savob/esc/hardware/schematics/esc_driver.pdf

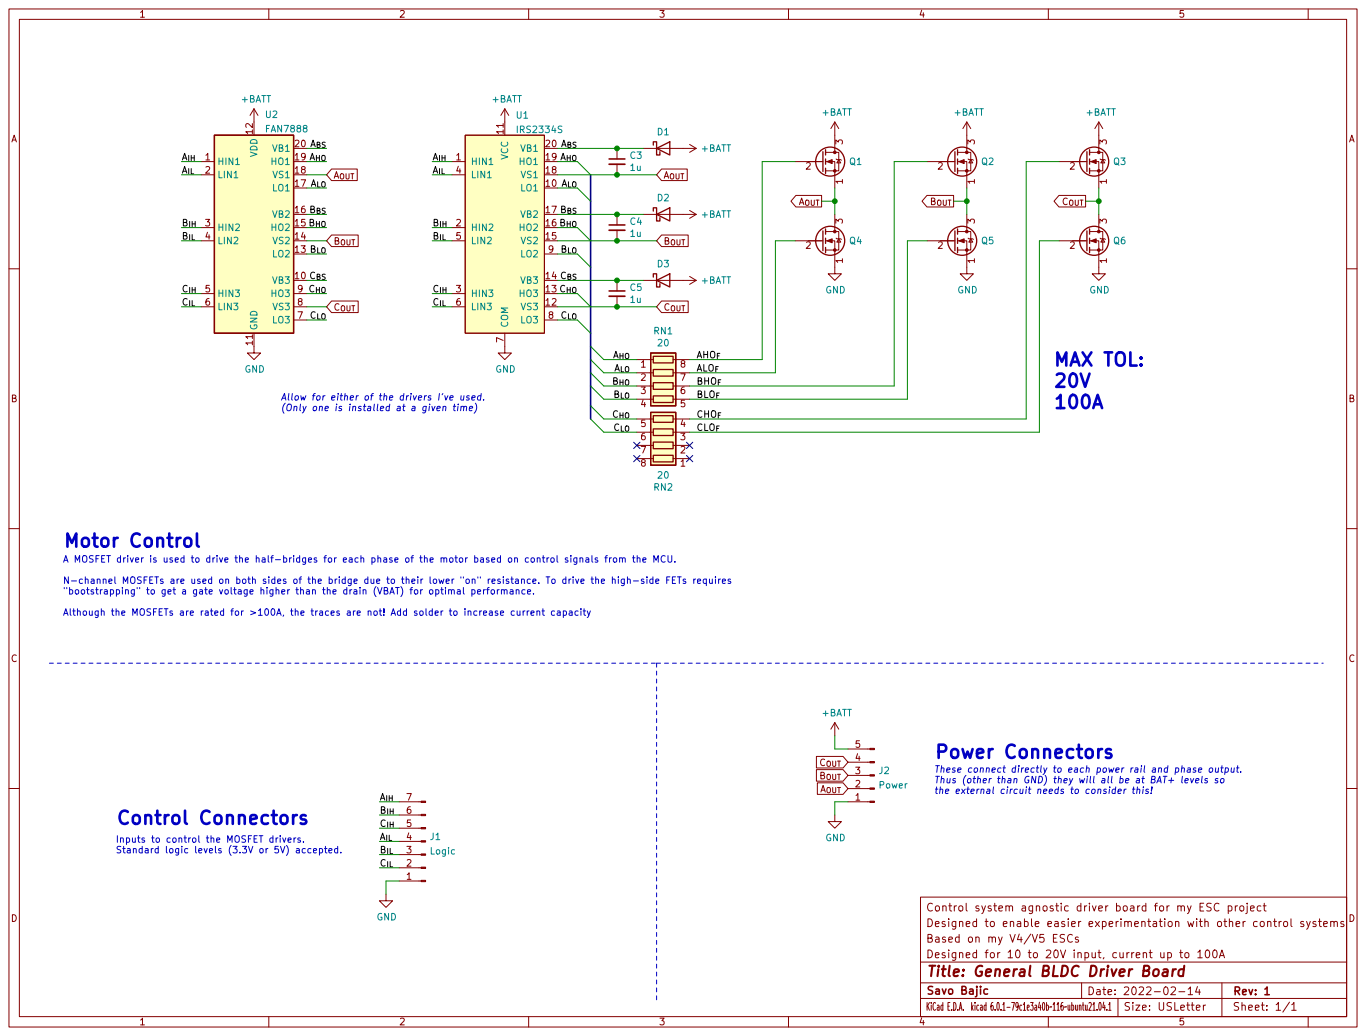
[picture p1: page 1]

Although the MOSFETs are rated for >100A, the traces are not! Add solder to increase current capacity Allow for either of the drivers I've used. (Only one is installed at a given time)

A MOSFET driver is used to drive the half-bridges for each phase of the motor based on control signals from the MCU.

N-channel MOSFETs are used on both sides of the bridge due to their lower "on" resistance. To drive the high-side FETs requires
"bootstrapping" to get a gate voltage higher than the drain (VBAT) for optimal performance.

the external circuit needs to consider this! Power Connectors

These connect directly to each power rail and phase output.
Thus (other than GND) they will all be at BAT+ levels so

Inputs to control the MOSFET drivers.
Standard logic levels (3.3V or 5V) accepted.

Control system agnostic driver board for my ESC project KiCad E.D.A. kicad 6.0.1-79c1e3a40b~116~ubuntu21.04.1
Designed to enable easier experimentation with other control systems
Based on my V4/V5 ESCs
Designed for 10 to 20V input, current up to 100A
