savob/esc/hardware/schematics/esc_V1.pdf

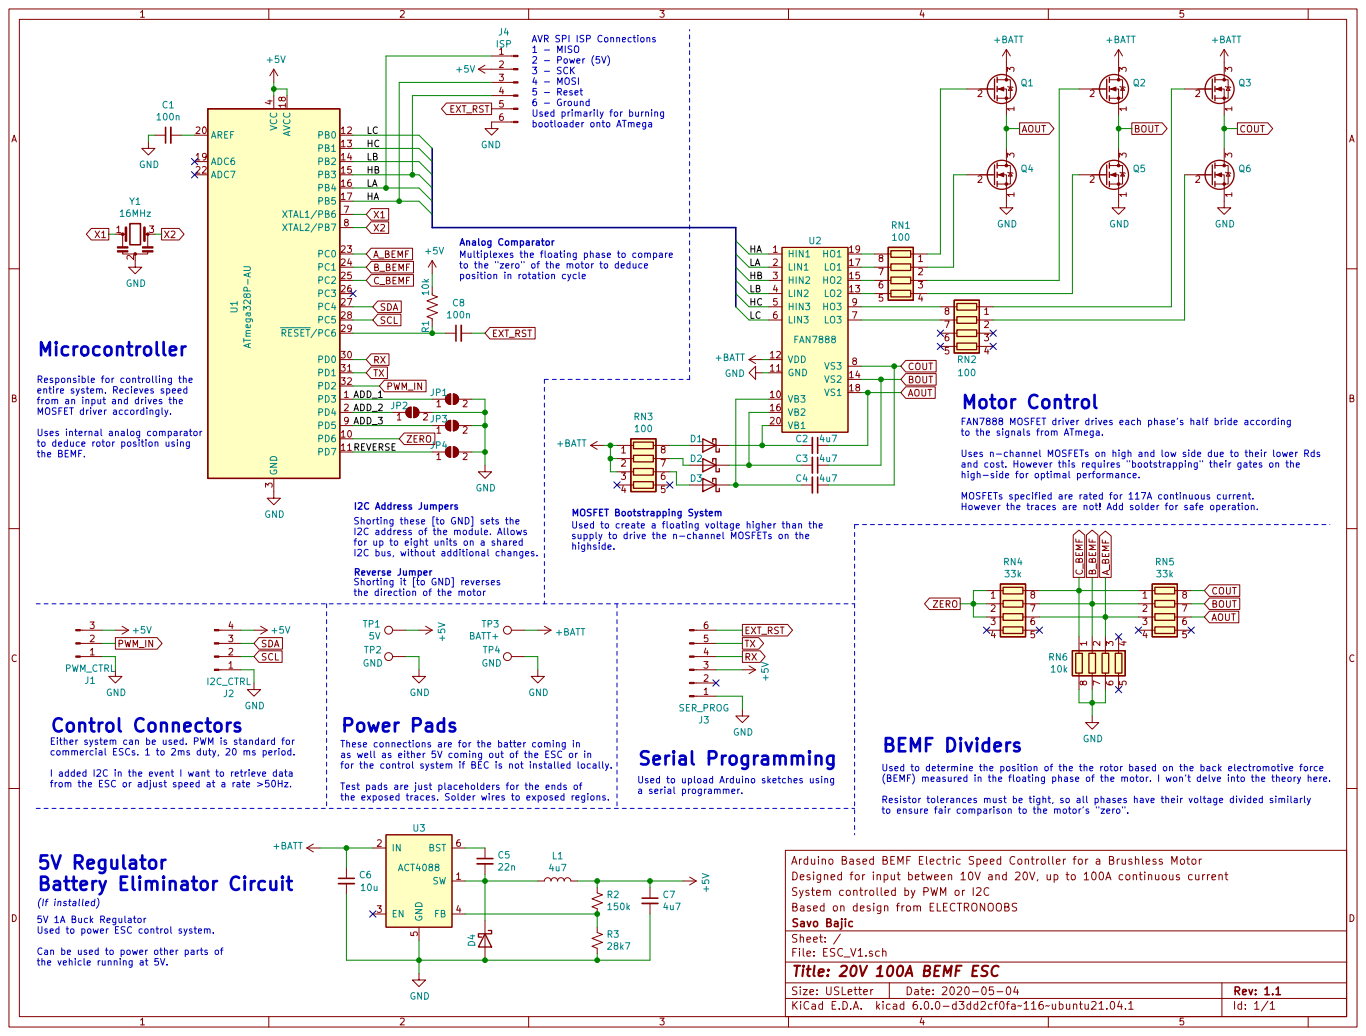
[picture p3: page 1]

HC
LB

Analog Comparator
Multiplexes the floating phase to compare
to the "zero" of the motor to deduce
position in rotation cycle

Responsible for controlling the
entire system. Recieves speed
from an input and drives the
MOSFET driver accordingly.

Uses internal analog comparator
to deduce rotor position using

to the signals from ATmega.

Uses n-channel MOSFETs on high and low side due to their lower Rds
and cost. However this requires "bootstrapping" their gates on the
high-side for optimal performance.

MOSFETs specified are rated for 117A continuous current.
However the traces are not! Add solder for safe operation.

I2C Address Jumpers
Shorting these [to GND] sets the
I2C address of the module. Allows
for up to eight units on a shared
I2C bus, without additional changes.

MOSFET Bootstrapping System
Used to create a floating voltage higher than the
supply to drive the n-channel MOSFETs on the
highside.

Shorting it [to GND] reverses

4u7 TP3 BATT+ TP4 GND GND +5V GND

Either system can be used. PWM is standard for
commercial ESCs. 1 to 2ms duty, 20 ms period.

These connections are for the batter coming in
as well as either 5V coming out of the ESC or in
for the control system if BEC is not installed locally.

I added I2C in the event I want to retrieve data
from the ESC or adjust speed at a rate >50Hz.

Used to determine the position of the the rotor based on the back electromotive force
(BEMF) measured in the floating phase of the motor. I won't delve into the theory here.

Test pads are just placeholders for the ends of
the exposed traces. Solder wires to exposed regions.

Used to upload Arduino sketches using
a serial programmer.

Resistor tolerances must be tight, so all phases have their voltage divided similarly
to ensure fair comparison to the motor's "zero".

Arduino Based BEMF Electric Speed Controller for a Brushless Motor R2

Designed for input between 10V and 20V, up to 100A continuous current
System controlled by PWM or I2C
Based on design from ELECTRONOOBS
File: ESC_V1.sch Sheet: / Savo Bajic

(If installed)
5V 1A Buck Regulator
Used to power ESC control system.

Can be used to power other parts of
the vehicle running at 5V.

Id: 1/1 Title: 20V 100A BEMF ESC
