savob/esc/hardware/esc_driver/esc_driver.kicad_pcb

## KiCad design hardware/esc_driver/esc_driver.kicad_pcb (2024-01-04)

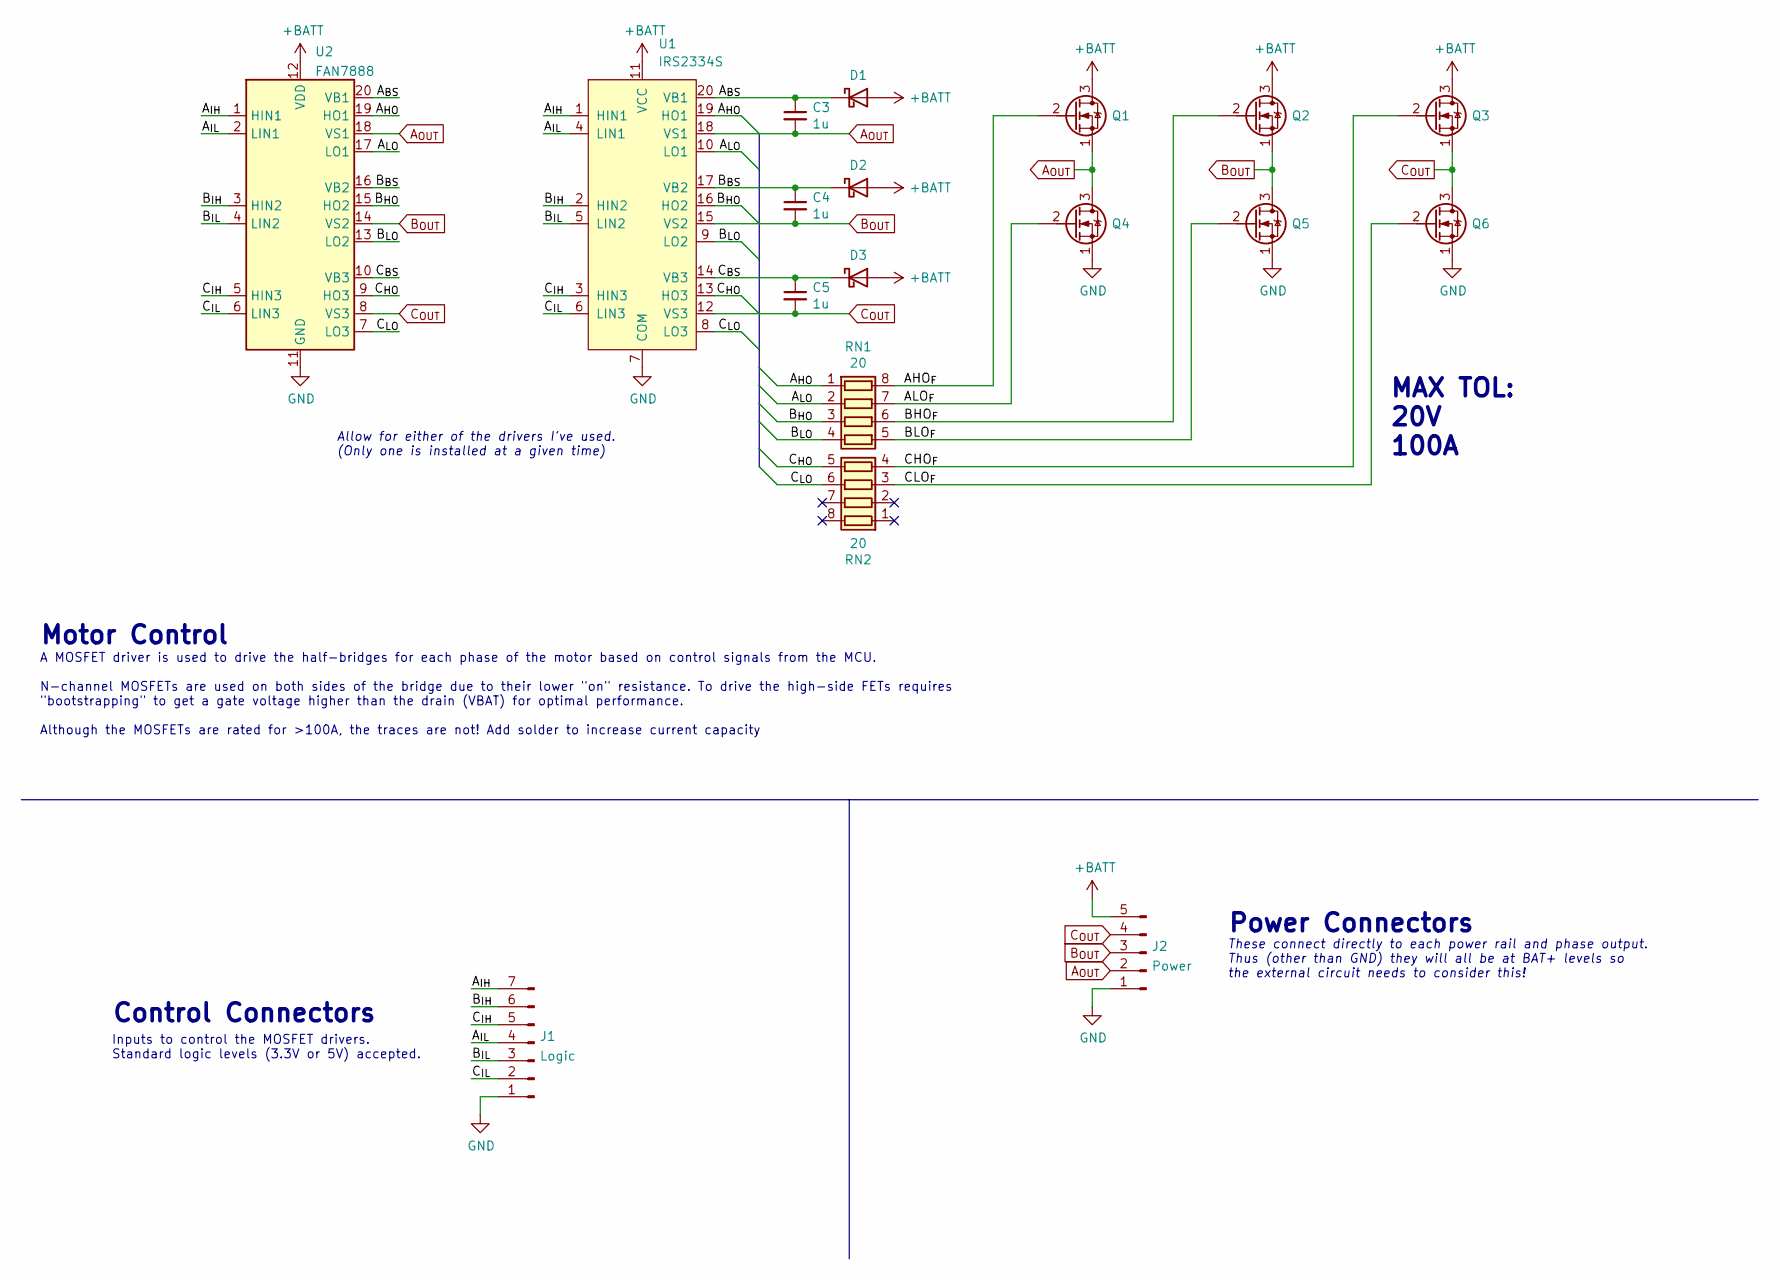
[picture p4: schematic esc_driver.kicad_sch, General BLDC Driver Board]

Parts:
C3, C4, C5: 1u; C_0603_1608Metric
D1, D2, D3: DSS15UTR; D_SOD-123F
J1: Logic; PinHeader_1x07_P2.54mm_Vertical
J2: Power; PinHeader_1x05_P2.54mm_Vertical
Q1, Q2, Q3, Q4, Q5, Q6: TPN2R903PL; TPN2R903PLL1Q
RN1, RN2: 20; R_Array_Convex_4x0603
U1: IRS2334S; SOIC-20W_7.5x12.8mm_P1.27mm
U2: FAN7888; SOIC-20W_7.5x12.8mm_P1.27mm

Connections:
+BATT: D1.2 (A), D2.2 (A), D3.2 (A), J2.5, Q1.3 (D), Q2.3 (D), Q3.3 (D), U1.11 (VCC), U2.12 (VDD)
/AHO_{F}: Q1.2 (G), RN1.8 (R1.2)
/ALO_{F}: Q4.2 (G), RN1.7 (R2.2)
/A_{BS}: C3.1, D1.1 (K), U1.20 (VB1), U2.20 (VB1)
/A_{HO}: RN1.1 (R1.1), U1.19 (HO1), U2.19 (HO1)
/A_{IH}: J1.7, U1.1 (HIN1), U2.1 (HIN1)
/A_{IL}: J1.4, U1.4 (LIN1), U2.2 (LIN1)
/A_{LO}: RN1.2 (R2.1), U1.10 (LO1), U2.17 (LO1)
/BHO_{F}: Q2.2 (G), RN1.6 (R3.2)
/BLO_{F}: Q5.2 (G), RN1.5 (R4.2)
/B_{BS}: C4.1, D2.1 (K), U1.17 (VB2), U2.16 (VB2)
/B_{HO}: RN1.3 (R3.1), U1.16 (HO2), U2.15 (HO2)
/B_{IH}: J1.6, U1.2 (HIN2), U2.3 (HIN2)
/B_{IL}: J1.3, U1.5 (LIN2), U2.4 (LIN2)
/B_{LO}: RN1.4 (R4.1), U1.9 (LO2), U2.13 (LO2)
/CHO_{F}: Q3.2 (G), RN2.4 (R4.1)
/CLO_{F}: Q6.2 (G), RN2.3 (R3.1)
/C_{BS}: C5.1, D3.1 (K), U1.14 (VB3), U2.10 (VB3)
/C_{HO}: RN2.5 (R4.2), U1.13 (HO3), U2.9 (HO3)
/C_{IH}: J1.5, U1.3 (HIN3), U2.5 (HIN3)
/C_{IL}: J1.2, U1.6 (LIN3), U2.6 (LIN3)
/C_{LO}: RN2.6 (R3.2), U1.8 (LO3), U2.7 (LO3)
A_{OUT}: C3.2, J2.2, Q1.1 (S), Q4.3 (D), U1.18 (VS1), U2.18 (VS1)
B_{OUT}: C4.2, J2.3, Q2.1 (S), Q5.3 (D), U1.15 (VS2), U2.14 (VS2)
C_{OUT}: C5.2, J2.4, Q3.1 (S), Q6.3 (D), U1.12 (VS3), U2.8 (VS3)
GND: J1.1, J2.1, Q4.1 (S), Q5.1 (S), Q6.1 (S), U1.7 (COM), U2.11 (GND)

Notes on the sheet:
A MOSFET driver is used to drive the half-bridges for each phase of the motor based on control signals from the MCU. N-channel MOSFETs are used on both sides of the bridge due to their lower "on" resistance. To drive the high-side FETs requires "bootstrapping" to get a gate voltage higher than the 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
These connect directly to each power rail and phase output. Thus (other than GND) they will all be at BAT+ levels so the external circuit needs to consider this!
Motor Control
Allow for either of the drivers I've used. (Only one is installed at a given time)
Power Connectors
MAX TOL: 20V 100A
Inputs to control the MOSFET drivers. Standard logic levels (3.3V or 5V) accepted.
Control Connectors

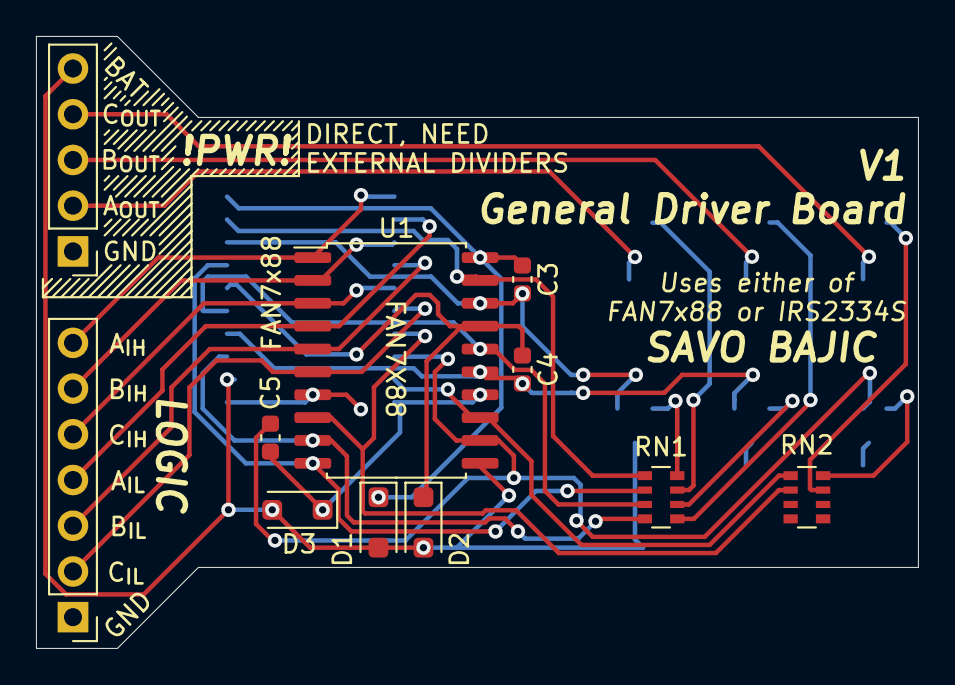
[picture p5: board esc_driver.kicad_pcb from above]

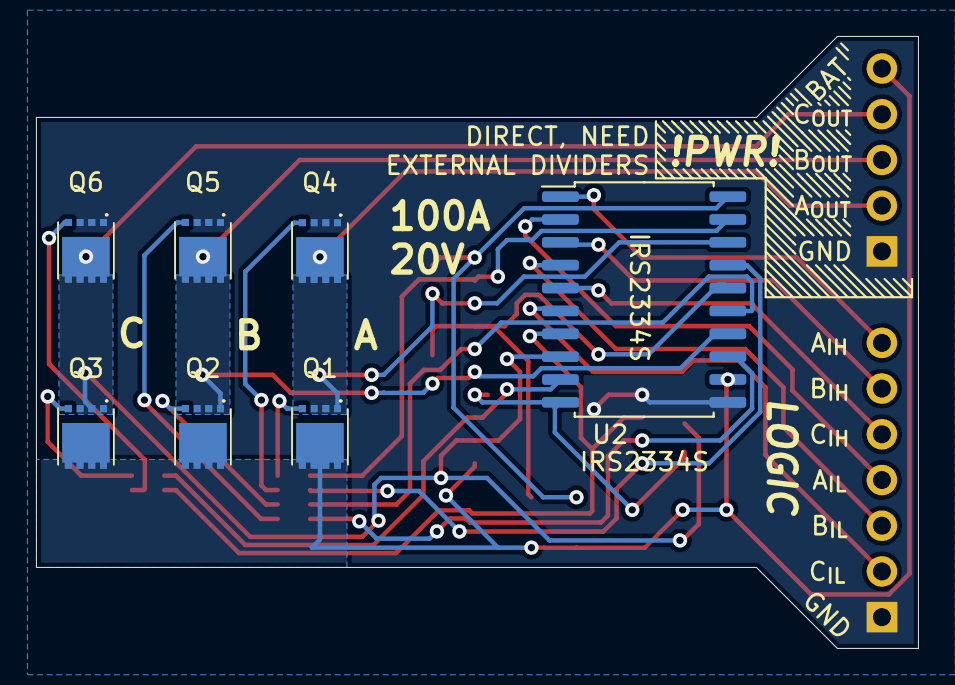
[picture p6: board esc_driver.kicad_pcb from below]

Board: 2 copper layers, 49.0 x 34.0 mm, 18 parts (7 on the bottom side), 26 nets.
