savob/esc/hardware/esc_v4/esc_v4.kicad_pcb

## KiCad design hardware/esc_v4/esc_v4.kicad_pcb (2024-01-04, an earlier design)

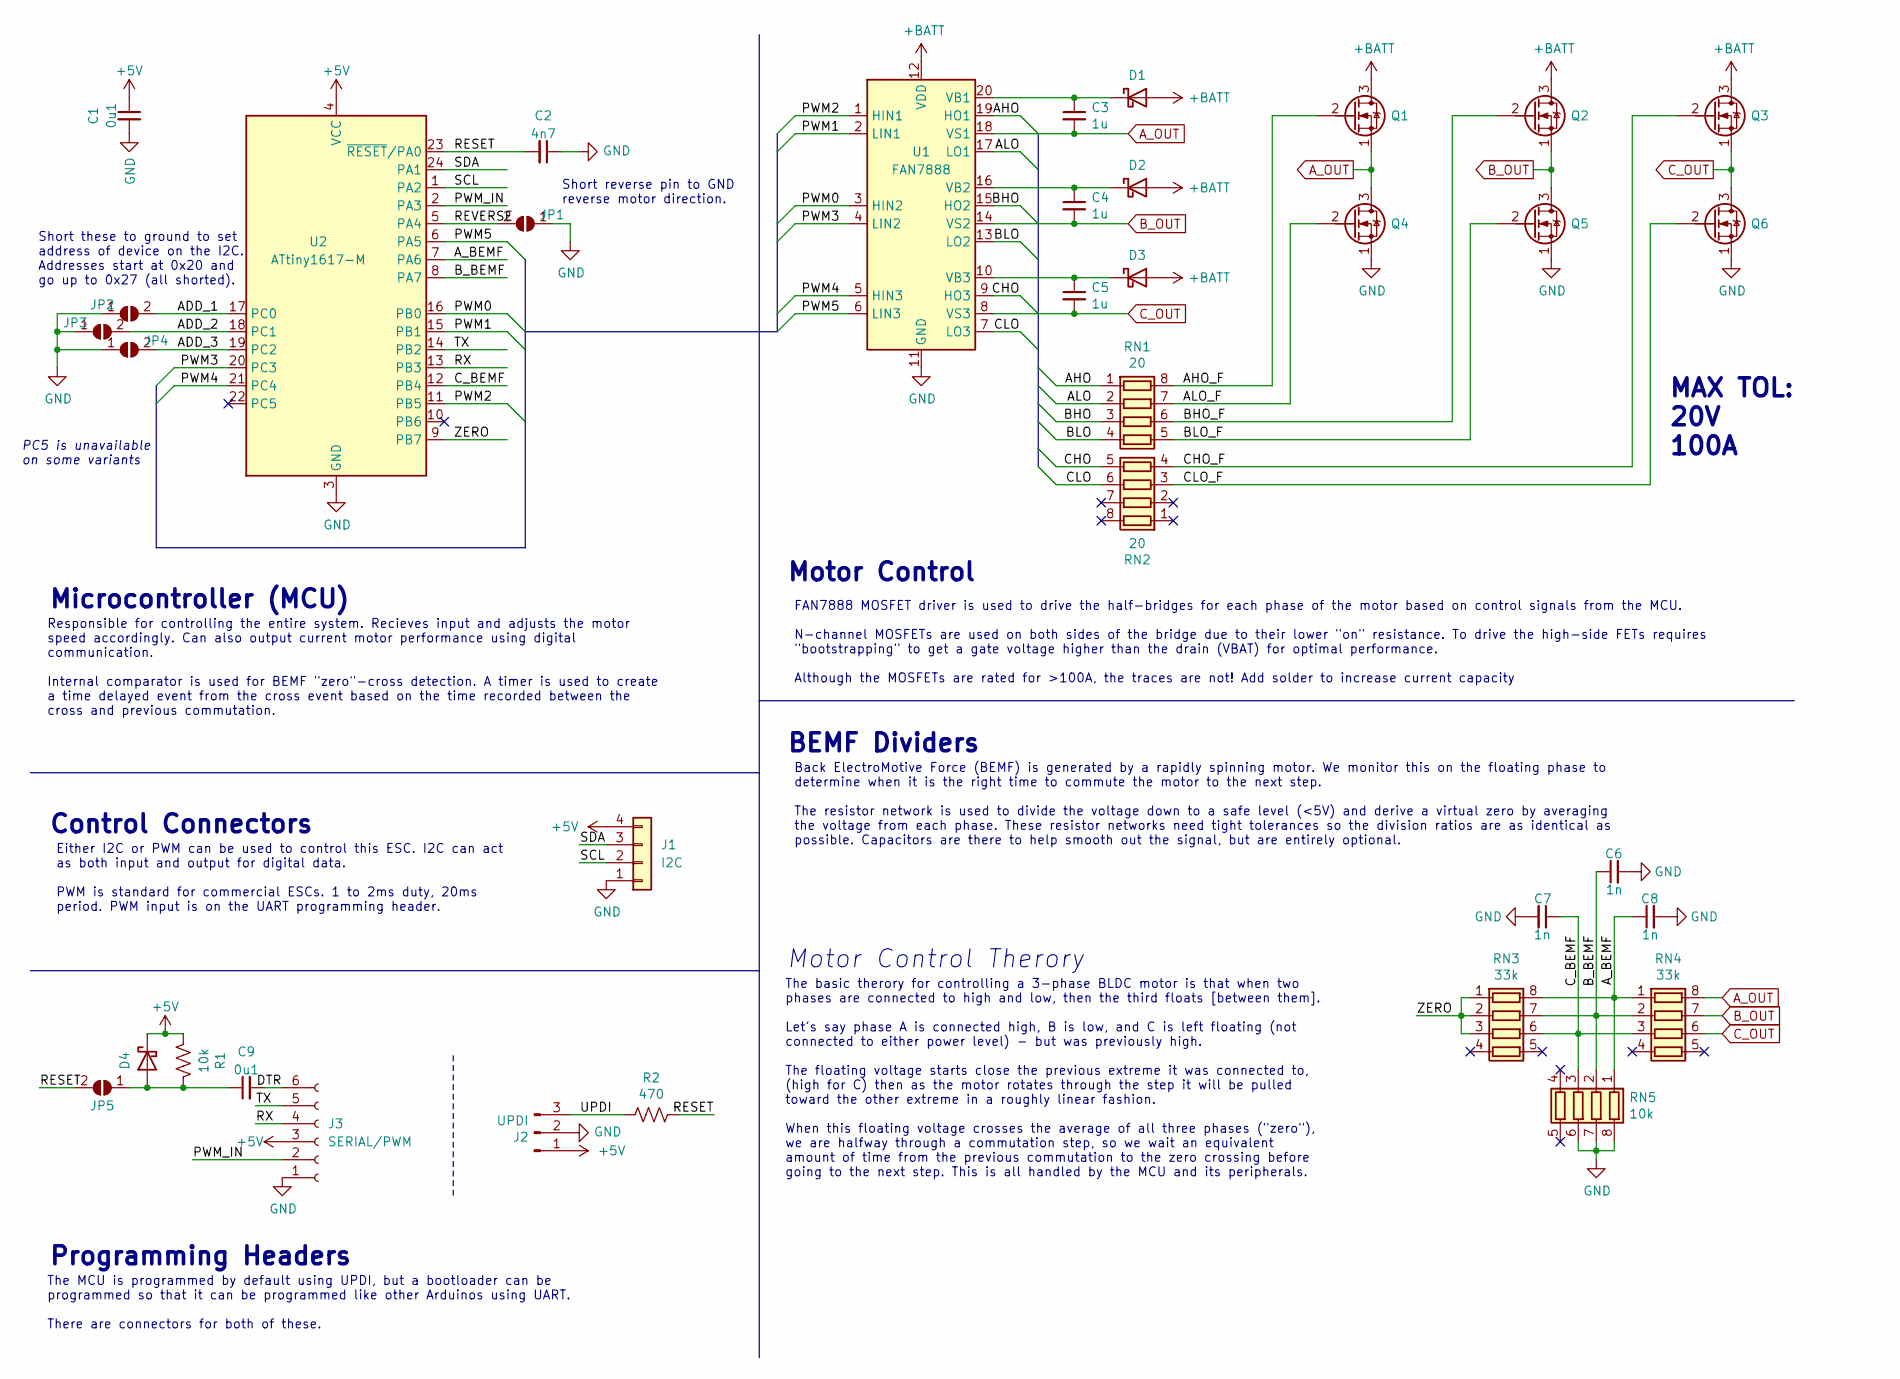
[picture p7: schematic esc_v4.kicad_sch, Sensorless BLDC ESC V4]

Parts:
C1, C9: 0u1; C_0402_1005Metric
C2: 4n7; C_0402_1005Metric
C3, C4, C5: 1u; C_0603_1608Metric
C6, C7, C8: 1n; C_0402_1005Metric
D1, D2, D3, D4: DSS15UTR; D_SOD-123F
J1: I2C; PinSocket_1x04_P2.54mm_Vertical
J2: UPDI; PinHeader_1x03_P2.54mm_Horizontal
J3: SERIAL/PWM; PinSocket_1x06_P2.54mm_Vertical
JP1, JP2, JP3, JP4: SolderJumper_2_Open; SolderJumper-2_P1.3mm_Open_TrianglePad1.0x1.5mm
JP5: SolderJumper_2_Open; SolderJumper-2_P1.3mm_Open_RoundedPad1.0x1.5mm
Q1, Q2, Q3, Q4, Q5, Q6: TPN2R903PL; TPN2R903PLL1Q
R1: 10k; R_0603_1608Metric
R2: 470; R_0603_1608Metric
RN1, RN2: 20; R_Array_Convex_4x0603
RN3, RN4: 33k; R_Array_Convex_4x0603
RN5: 10k; R_Cat16-4
U1: FAN7888; SOIC-20W_7.5x12.8mm_P1.27mm
U2: ATtiny1617-M; QFN-24-1EP_4x4mm_P0.5mm_EP2.6x2.6mm

Connections:
+5V: C1.1, D4.1 (K), J1.4, J2.1, J3.3, R1.1, U2.4 (VCC)
+BATT: D1.2 (A), D2.2 (A), D3.2 (A), Q1.3 (D), Q2.3 (D), Q3.3 (D), U1.12 (VDD)
/ADD_1: JP2.2 (B), U2.17 (PC0)
/ADD_2: JP3.2 (B), U2.18 (PC1)
/ADD_3: JP4.2 (B), U2.19 (PC2)
/AHO: RN1.1 (R1.1), U1.19 (HO1)
/AHO_F: Q1.2 (G), RN1.8 (R1.2)
/ALO: RN1.2 (R2.1), U1.17 (LO1)
/ALO_F: Q4.2 (G), RN1.7 (R2.2)
/A_BEMF: C8.1, RN3.8 (R1.2), RN4.1 (R1.1), RN5.1 (R1.1), U2.7 (PA6)
/BHO: RN1.3 (R3.1), U1.15 (HO2)
/BHO_F: Q2.2 (G), RN1.6 (R3.2)
/BLO: RN1.4 (R4.1), U1.13 (LO2)
/BLO_F: Q5.2 (G), RN1.5 (R4.2)
/B_BEMF: C6.1, RN3.7 (R2.2), RN4.2 (R2.1), RN5.2 (R2.1), U2.8 (PA7)
/CHO: RN2.5 (R4.2), U1.9 (HO3)
/CHO_F: Q3.2 (G), RN2.4 (R4.1)
/CLO: RN2.6 (R3.2), U1.7 (LO3)
/CLO_F: Q6.2 (G), RN2.3 (R3.1)
/C_BEMF: C7.1, RN3.6 (R3.2), RN4.3 (R3.1), RN5.3 (R3.1), U2.12 (PB4)
/DTR: C9.2, J3.6
/PWM0: U1.3 (HIN2), U2.16 (PB0)
/PWM1: U1.2 (LIN1), U2.15 (PB1)
/PWM2: U1.1 (HIN1), U2.11 (PB5)
/PWM3: U1.4 (LIN2), U2.20 (PC3)
/PWM4: U1.5 (HIN3), U2.21 (PC4)
/PWM5: U1.6 (LIN3), U2.6 (PA5)
/PWM_IN: J3.2, U2.2 (PA3)
/RESET: C2.2, JP5.2 (B), R2.1, U2.23 (~RESET/PA0)
/REVERSE: JP1.2 (B), U2.5 (PA4)
/RX: J3.4, U2.13 (PB3)
/SCL: J1.2, U2.1 (PA2)
/SDA: J1.3, U2.24 (PA1)
/TX: J3.5, U2.14 (PB2)
/UPDI: J2.3, R2.2
/ZERO: RN3.1 (R1.1), RN3.2 (R2.1), RN3.3 (R3.1), U2.9 (PB7)
A_OUT: C3.2, Q1.1 (S), Q4.3 (D), RN4.8 (R1.2), U1.18 (VS1)
B_OUT: C4.2, Q2.1 (S), Q5.3 (D), RN4.7 (R2.2), U1.14 (VS2)
C_OUT: C5.2, Q3.1 (S), Q6.3 (D), RN4.6 (R3.2), U1.8 (VS3)
GND: C1.2, C2.1, C6.2, C7.2, C8.2, J1.1, J2.2, J3.1, JP1.1 (A), JP2.1 (A), JP3.1 (A), JP4.1 (A), Q4.1 (S), Q5.1 (S), Q6.1 (S), RN5.6 (R3.2), RN5.7 (R2.2), RN5.8 (R1.2), U1.11 (GND), U2.3 (GND), U2.25 (GND)
unnamed: C3.1, D1.1 (K), U1.20 (VB1)
unnamed: C4.1, D2.1 (K), U1.16 (VB2)
unnamed: C5.1, D3.1 (K), U1.10 (VB3)
unnamed: C9.1, D4.2 (A), JP5.1 (A), R1.2

Notes on the sheet:
Back ElectroMotive Force (BEMF) is generated by a rapidly spinning motor. We monitor this on the floating phase to determine when it is the right time to commute the motor to the next step. The resistor network is used to divide the voltage down to a safe level (<5V) and derive a virtual zero by av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
The basic therory for controlling a 3-phase BLDC motor is that when two phases are connected to high and low, then the third floats [between them]. Let's say phase A is connected high, B is low, and C is left floating (not connected to either power level) - but was previously high. The floating vol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
FAN7888 MOSFET driver is used to drive the half-bridges for each phase of the motor based on control signals from the MCU. N-channel MOSFETs are used on both sides of the bridge due to their lower "on" resistance. To drive the high-side FETs requires "bootstrapping" to get a gate voltage higher tha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
Either I2C or PWM can be used to control this ESC. I2C can act as both input and output for digital data. PWM is standard for commercial ESCs. 1 to 2ms duty, 20ms period. PWM input is on the UART programming header.
The MCU is programmed by default using UPDI, but a bootloader can be programmed so that it can be programmed like other Arduinos using UART. There are connectors for both of these.
Responsible for controlling the entire system. Recieves input and adjusts the motor speed accordingly. Can also output current motor performance using digital communication. Internal comparator is used for BEMF "zero"-cross detection. A timer is used to create a time delayed event from the cross ev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
Short these to ground to set address of device on the I2C. Addresses start at 0x20 and go up to 0x27 (all shorted).
Microcontroller (MCU)
MAX TOL: 20V 100A
Motor Control Therory
PC5 is unavailable on some variants
Control Connectors
Programming Headers
Short reverse pin to GND reverse motor direction.
Motor Control
BEMF Dividers

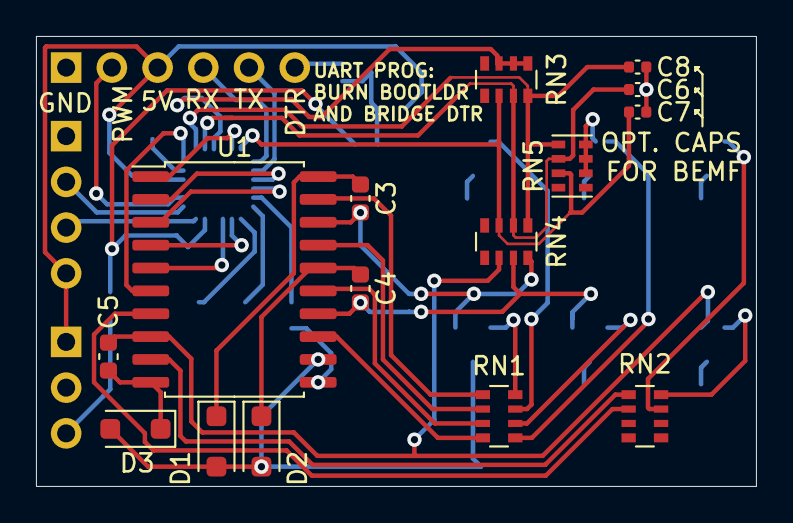
[picture p8: board esc_v4.kicad_pcb from above]

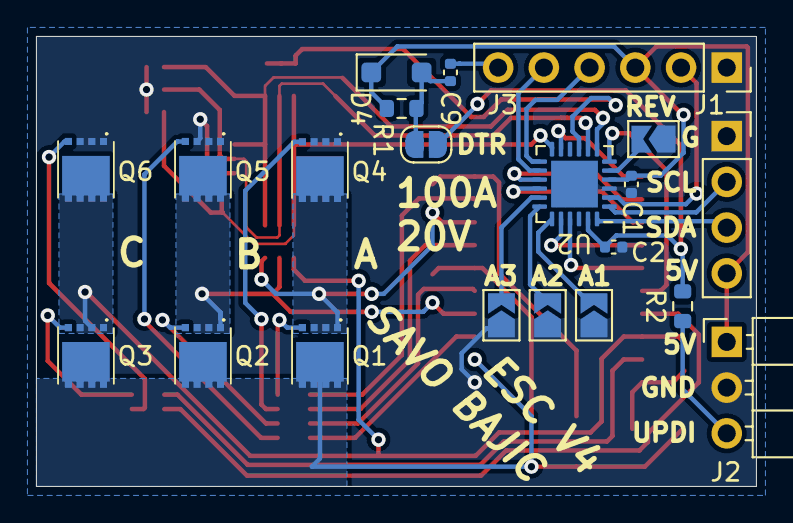
[picture p9: board esc_v4.kicad_pcb from below]

Board: 2 copper layers, 40.0 x 25.0 mm, 36 parts (21 on the bottom side), 44 nets.
