savob/esc/hardware/esc_v2/esc_v2.kicad_pcb

## KiCad design hardware/esc_v2/esc_v2.kicad_pcb (2024-01-04, an earlier design)

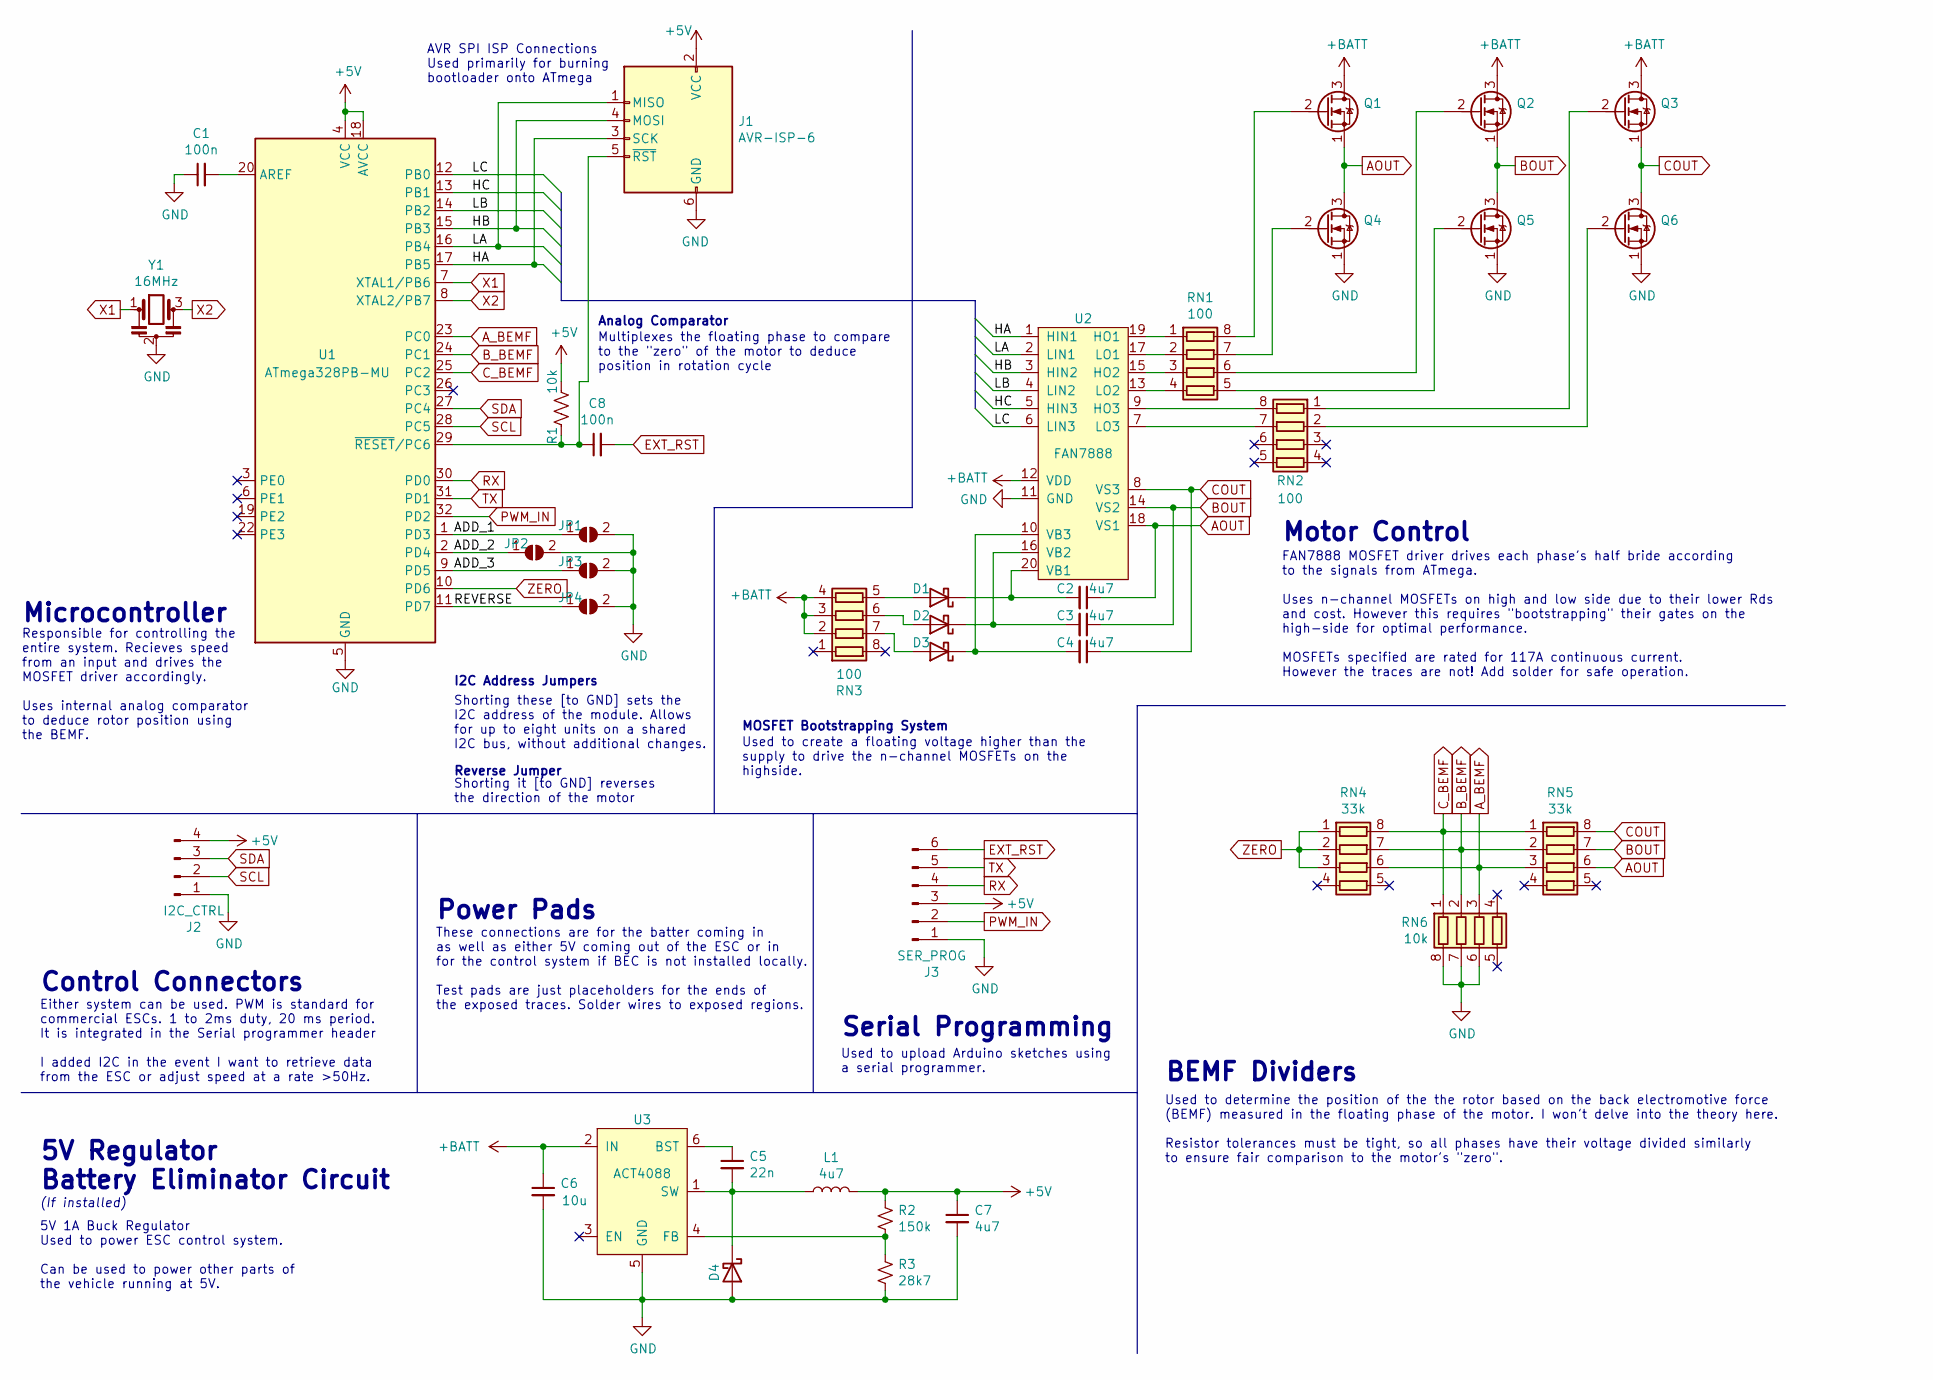
[picture p10: schematic esc_v2.kicad_sch, 20V 100A BEMF ESC]

Parts:
C1, C8: 100n; C_0402_1005Metric
C2, C3, C4, C7: 4u7; C_0805_2012Metric
C5: 22n; C_0402_1005Metric
C6: 10u; C_0805_2012Metric
D1, D2, D3, D4: 0v8; D_SOD-323
J1: AVR-ISP-6; PinHeader_2x03_P2.54mm_Vertical_SMD
J2: I2C_CTRL; PinHeader_1x04_P2.54mm_Vertical
J3: SER_PROG; PinSocket_1x06_P2.54mm_Vertical
JP1: A1; SolderJumper-2_P1.3mm_Open_TrianglePad1.0x1.5mm
JP2: A2; SolderJumper-2_P1.3mm_Open_TrianglePad1.0x1.5mm
JP3: A3; SolderJumper-2_P1.3mm_Open_TrianglePad1.0x1.5mm
JP4: REV; SolderJumper-2_P1.3mm_Open_TrianglePad1.0x1.5mm
L1: 4u7; L_Taiyo-Yuden_NR-30xx
Q1, Q2, Q3, Q4, Q5, Q6: Q_NMOS_SGD; TPN2R903PLL1Q
R1: 10k; R_0402_1005Metric
R2: 150k; R_0402_1005Metric
R3: 28k7; R_0402_1005Metric
RN1, RN2, RN3: 100; R_Array_Convex_4x0402
RN4, RN5: 33k; R_Array_Convex_4x0402
RN6: 10k; R_Array_Convex_4x0402
U1: ATmega328PB-MU; QFN-32-1EP_5x5mm_P0.5mm_EP3.1x3.1mm
U2: FAN7888; SOIC-20W_7.5x12.8mm_P1.27mm
U3: ACT4088; SOT-23-6
Y1: 16MHz; Resonator_SMD_muRata_CSTxExxV-3Pin_3.0x1.1mm

Connections:
+5V: C7.1, J1.2 (VCC), J2.4, J3.3, L1.2, R1.1, R2.2, U1.4 (VCC), U1.18 (AVCC)
+BATT: C6.1, Q1.3 (D), Q2.3 (D), Q3.3 (D), RN3.2 (R2.1), RN3.3 (R3.1), RN3.4 (R4.1), U2.12 (VDD), U3.2 (IN)
/ADD_1: JP1.1 (A), U1.1 (PD3)
/ADD_2: JP2.1 (A), U1.2 (PD4)
/ADD_3: JP3.1 (A), U1.9 (PD5)
/HA: J1.3 (SCK), U1.17 (PB5), U2.1 (HIN1)
/HB: J1.4 (MOSI), U1.15 (PB3), U2.3 (HIN2)
/HC: U1.13 (PB1), U2.5 (HIN3)
/LA: J1.1 (MISO), U1.16 (PB4), U2.2 (LIN1)
/LB: U1.14 (PB2), U2.4 (LIN2)
/LC: U1.12 (PB0), U2.6 (LIN3)
/REVERSE: JP4.1 (A), U1.11 (PD7)
AOUT: C2.1, Q1.1 (S), Q4.3 (D), RN5.6 (R3.2), U2.18 (VS1)
A_BEMF: RN4.6 (R3.2), RN5.3 (R3.1), RN6.3 (R3.1), U1.23 (PC0)
BOUT: C3.1, Q2.1 (S), Q5.3 (D), RN5.7 (R2.2), U2.14 (VS2)
B_BEMF: RN4.7 (R2.2), RN5.2 (R2.1), RN6.2 (R2.1), U1.24 (PC1)
COUT: C4.1, Q3.1 (S), Q6.3 (D), RN5.8 (R1.2), U2.8 (VS3)
C_BEMF: RN4.8 (R1.2), RN5.1 (R1.1), RN6.1 (R1.1), U1.25 (PC2)
EXT_RST: C8.2, J3.6
GND: C1.1, C6.2, C7.2, D4.2 (A), J1.6 (GND), J2.1, J3.1, JP1.2 (B), JP2.2 (B), JP3.2 (B), JP4.2 (B), Q4.1 (S), Q5.1 (S), Q6.1 (S), R3.1, RN6.6 (R3.2), RN6.7 (R2.2), RN6.8 (R1.2), U1.5 (GND), U1.21 (GND), U1.33 (GND), U2.11 (GND), U3.5 (GND), Y1.2
unnamed: D1.2 (A), RN3.5 (R4.2)
unnamed: C2.2, D1.1 (K), U2.20 (VB1)
unnamed: D2.2 (A), RN3.6 (R3.2)
unnamed: C3.2, D2.1 (K), U2.16 (VB2)
unnamed: D3.2 (A), RN3.7 (R2.2)
unnamed: C4.2, D3.1 (K), U2.10 (VB3)
unnamed: C5.2, D4.1 (K), L1.1, U3.1 (SW)
unnamed: C8.1, J1.5 (~RST), R1.2, U1.29 (~RESET/PC6)
unnamed: Q1.2 (G), RN1.8 (R1.2)
unnamed: Q2.2 (G), RN1.6 (R3.2)
unnamed: Q3.2 (G), RN2.1 (R1.1)
unnamed: Q4.2 (G), RN1.7 (R2.2)
unnamed: Q5.2 (G), RN1.5 (R4.2)
unnamed: Q6.2 (G), RN2.2 (R2.1)
unnamed: RN1.1 (R1.1), U2.19 (HO1)
unnamed: RN1.2 (R2.1), U2.17 (LO1)
unnamed: RN1.3 (R3.1), U2.15 (HO2)
unnamed: RN1.4 (R4.1), U2.13 (LO2)
unnamed: RN2.8 (R1.2), U2.9 (HO3)
unnamed: RN2.7 (R2.2), U2.7 (LO3)
unnamed: C1.2, U1.20 (AREF)
unnamed: C5.1, U3.6 (BST)
unnamed: R2.1, R3.2, U3.4 (FB)
PWM_IN: J3.2, U1.32 (PD2)
RX: J3.4, U1.30 (PD0)
SCL: J2.2, U1.28 (PC5)
SDA: J2.3, U1.27 (PC4)
TX: J3.5, U1.31 (PD1)
X1: U1.7 (XTAL1/PB6), Y1.1
X2: U1.8 (XTAL2/PB7), Y1.3
ZERO: RN4.1 (R1.1), RN4.2 (R2.1), RN4.3 (R3.1), U1.10 (PD6)

Notes on the sheet:
Serial Programming
5V 1A Buck Regulator Used to power ESC control system. Can be used to power other parts of the vehicle running at 5V.
AVR SPI ISP Connections Used primarily for burning bootloader onto ATmega
BEMF Dividers
Analog Comparator
Used to upload Arduino sketches using a serial programmer.
Shorting it [to GND] reverses the direction of the motor
Reverse Jumper
Shorting these [to GND] sets the I2C address of the module. Allows for up to eight units on a shared I2C bus, without additional changes.
These connections are for the batter coming in as well as either 5V coming out of the ESC or in for the control system if BEC is not installed locally. Test pads are just placeholders for the ends of the exposed traces. Solder wires to exposed regions.
Responsible for controlling the entire system. Recieves speed from an input and drives the MOSFET driver accordingly. Uses internal analog comparator to deduce rotor position using the BEMF.
Used to determine the position of the the rotor based on the back electromotive force (BEMF) measured in the floating phase of the motor. I won't delve into the theory here. Resistor tolerances must be tight, so all phases have their voltage divided similarly to ensure fair comparison to the motor'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
Control Connectors
Microcontroller
(If installed)
FAN7888 MOSFET driver drives each phase's half bride according to the signals from ATmega. Uses n-channel MOSFETs on high and low side due to their lower Rds and cost. However this requires "bootstrapping" their gates on the high-side for optimal performance. MOSFETs specified are rated for 117A co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
Either system can be used. PWM is standard for commercial ESCs. 1 to 2ms duty, 20 ms period. It is integrated in the Serial programmer header I added I2C in the event I want to retrieve data from the ESC or adjust speed at a rate >50Hz.
Used to create a floating voltage higher than the supply to drive the n-channel MOSFETs on the highside.
Motor Control
5V Regulator Battery Eliminator Circuit
I2C Address Jumpers
MOSFET Bootstrapping System
Power Pads
Multiplexes the floating phase to compare to the "zero" of the motor to deduce position in rotation cycle

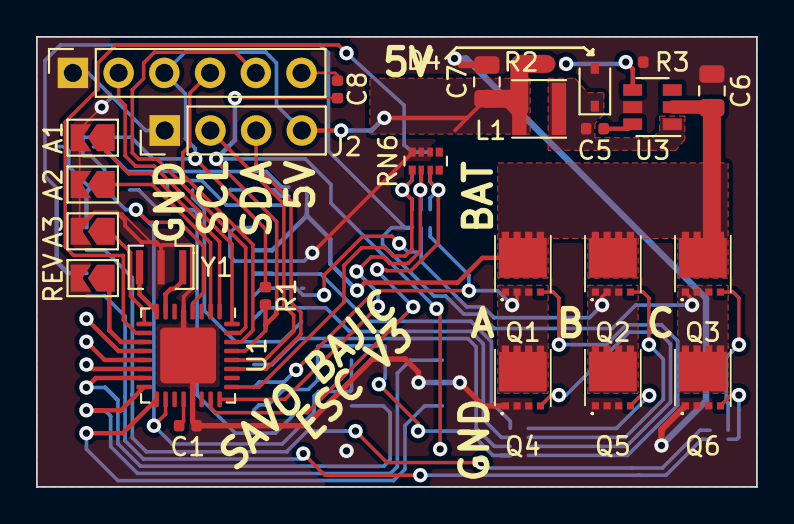
[picture p11: board esc_v2.kicad_pcb from above]

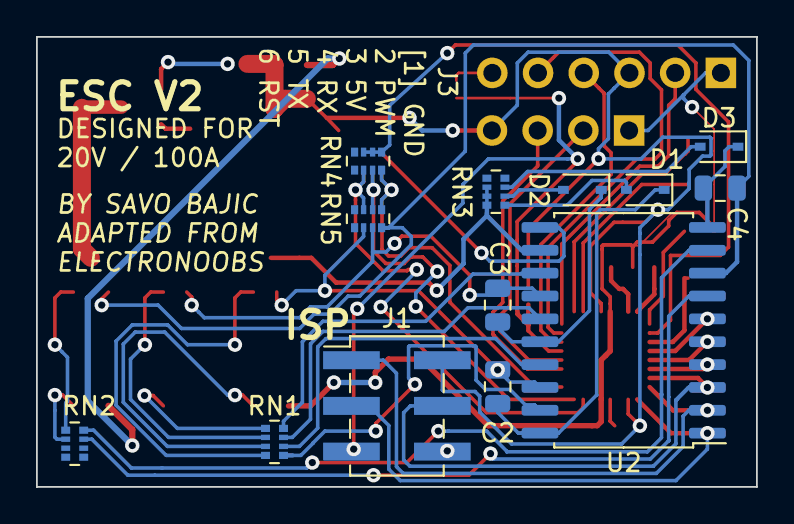
[picture p12: board esc_v2.kicad_pcb from below]

Board: 2 copper layers, 40.0 x 25.0 mm, 39 parts (13 on the bottom side), 51 nets.
