savob/esc/hardware/esc_v6/esc_v6.kicad_pcb

## KiCad design hardware/esc_v6/esc_v6.kicad_pcb (2024-01-04)

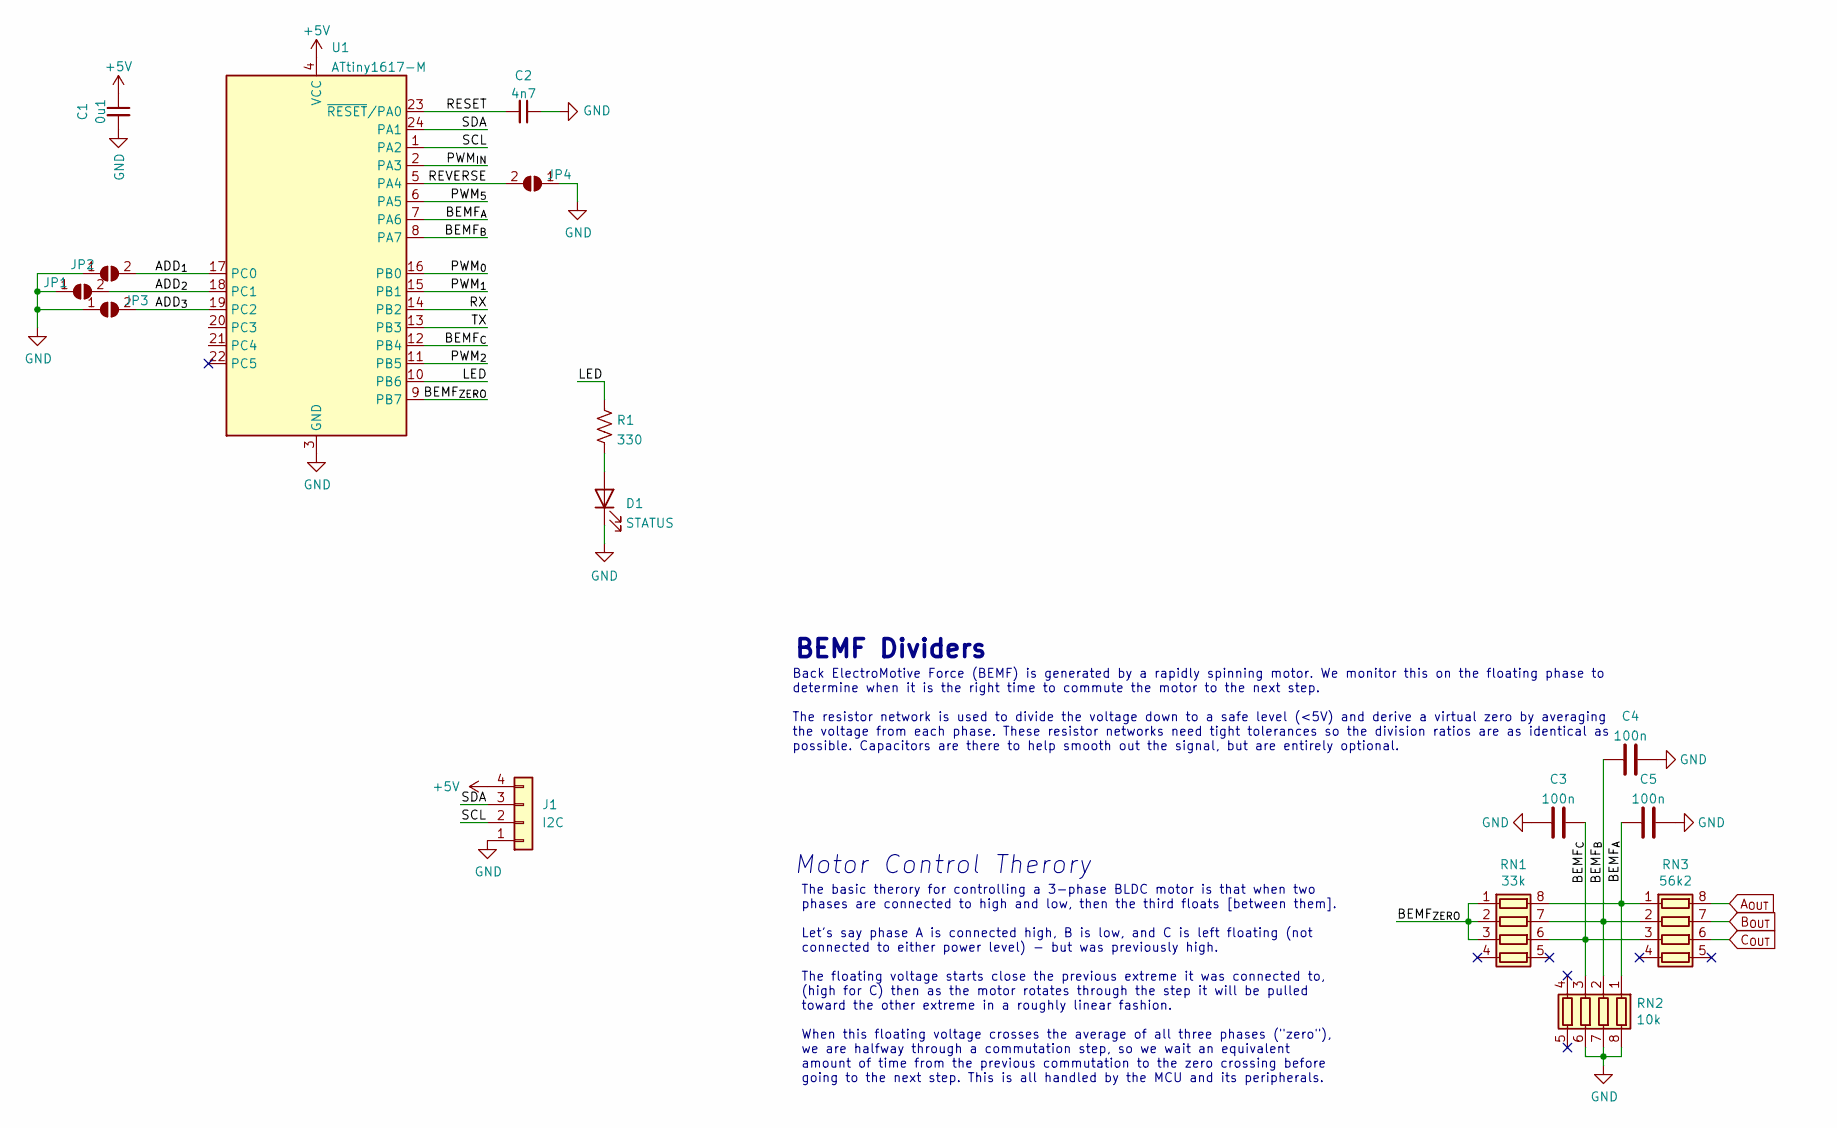
[picture p13: schematic esc_v6.kicad_sch, Sensorless BLDC ESC]

Parts:
C1: 0u1; C_0603_1608Metric
C2: 4n7; C_0603_1608Metric
C3, C4, C5: 100n; C_0603_1608Metric
D1: STATUS; LED_0805_2012Metric
J1: I2C; PinSocket_1x04_P2.54mm_Vertical
JP1, JP2, JP3, JP4: SolderJumper_2_Open; SolderJumper-2_P1.3mm_Open_TrianglePad1.0x1.5mm
R1: 330; R_0603_1608Metric
RN1: 33k; R_Array_Convex_4x0603
RN2: 10k; R_Cat16-4
RN3: 56k2; R_Array_Convex_4x0603
U1: ATtiny1617-M; QFN-24-1EP_4x4mm_P0.5mm_EP2.6x2.6mm

Connections:
+5V: C1.1, J1.4, U1.4 (VCC)
/ADD_{1}: JP2.2 (B), U1.17 (PC0)
/ADD_{2}: JP1.2 (B), U1.18 (PC1)
/ADD_{3}: JP3.2 (B), U1.19 (PC2)
/BEMF_{A}: C5.2, RN1.8 (R1.2), RN2.1 (R1.1), RN3.1 (R1.1), U1.7 (PA6)
/BEMF_{B}: C4.1, RN1.7 (R2.2), RN2.2 (R2.1), RN3.2 (R2.1), U1.8 (PA7)
/BEMF_{C}: C3.2, RN1.6 (R3.2), RN2.3 (R3.1), RN3.3 (R3.1), U1.12 (PB4)
/BEMF_{ZERO}: RN1.1 (R1.1), RN1.2 (R2.1), RN1.3 (R3.1), U1.9 (PB7)
/LED: R1.1, U1.10 (PB6)
/PWM_{0}: U1.16 (PB0)
/PWM_{1}: U1.15 (PB1)
/PWM_{2}: U1.11 (PB5)
/PWM_{3}: U1.20 (PC3)
/PWM_{4}: U1.21 (PC4)
/PWM_{5}: U1.6 (PA5)
/PWM_{IN}: U1.2 (PA3)
/RESET: C2.2, U1.23 (~RESET/PA0)
/REVERSE: JP4.2 (B), U1.5 (PA4)
/RX: U1.14 (PB2)
/SCL: J1.2, U1.1 (PA2)
/SDA: J1.3, U1.24 (PA1)
/TX: U1.13 (PB3)
A_{OUT}: RN3.8 (R1.2)
B_{OUT}: RN3.7 (R2.2)
C_{OUT}: RN3.6 (R3.2)
GND: C1.2, C2.1, C3.1, C4.2, C5.1, D1.1 (K), J1.1, JP1.1 (A), JP2.1 (A), JP3.1 (A), JP4.1 (A), RN2.6 (R3.2), RN2.7 (R2.2), RN2.8 (R1.2), U1.3 (GND), U1.25 (GND)
unnamed: D1.2 (A), R1.2

Notes on the sheet:
Back ElectroMotive Force (BEMF) is generated by a rapidly spinning motor. We monitor this on the floating phase to determine when it is the right time to commute the motor to the next step. The resistor network is used to divide the voltage down to a safe level (<5V) and derive a virtual zero by av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
The basic therory for controlling a 3-phase BLDC motor is that when two phases are connected to high and low, then the third floats [between them]. Let's say phase A is connected high, B is low, and C is left floating (not connected to either power level) - but was previously high. The floating vol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
BEMF Dividers
Motor Control Therory

Board: 4 copper layers, 16 parts (0 on the bottom side), 15 nets, no tracks yet.
