savob/esc/(commit log)

2024-01-04 Uploaded hardware files
    [driver_ic_adapter.kicad_pcb, driver_ic_adapter.kicad_sch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]
2024-01-04 Uploading early (Arduino IDE) ESC code
